Divisekara/Power-Supply-100W/photos/20190405_001616.jpg

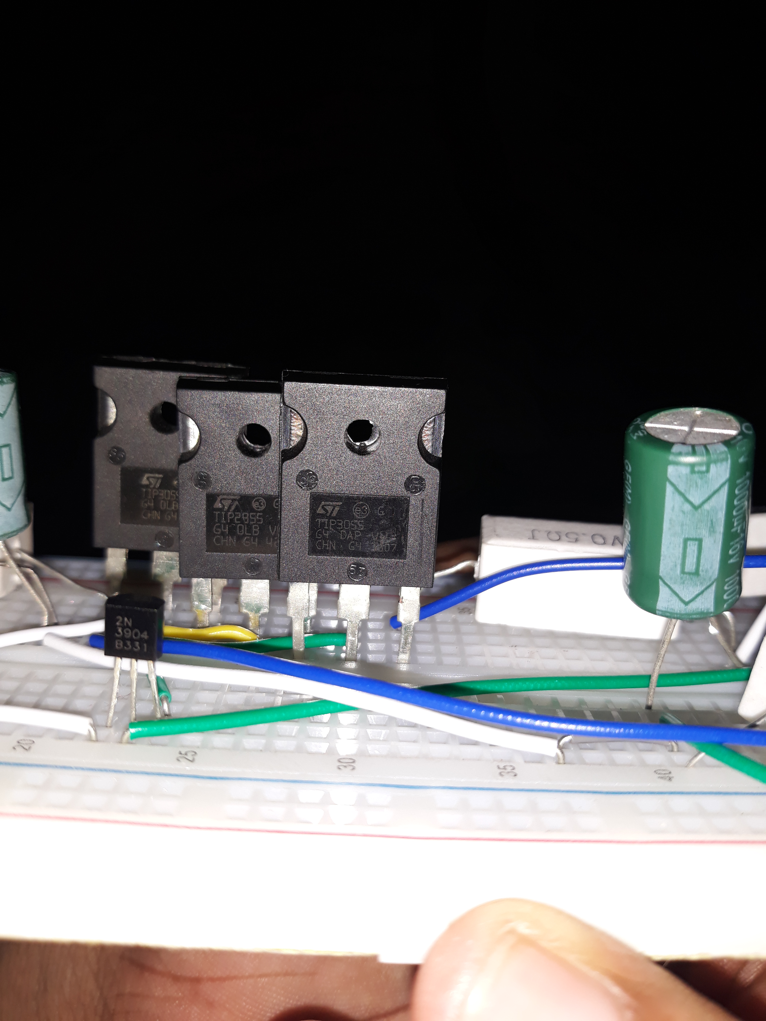
photos/20190405_001616.jpg
