Divisekara/Power-Supply-100W/README.md

# Power Supply 100W
 Smester 3 Lab project
