Divisekara/Power-Supply-100W/POWER SUPPLY/Preliminary Design.docx

Preliminary Design

AC input (230v)

Step Down Transformer

Full Wave Rectifier

Voltage Regulator

Current Amplifier

Output 100W 10A max

SECONDARY DESIGN (With Feedback Circuit )

Current Amplifier

Output 100W 10A max

Unregulated Input

Feedback signal

Reference voltage

Comparator circuit

Sampling circuit
