Divisekara/Power-Supply-100W/POWER SUPPLY/sathira.docx

week1

week2

week3

week4

week5

week6

week7

week8

concept research and circuit simulation

Preliminary Circuit design

Circuit design Finalizing

PCB design and Printing

Soldering and assembly of electronic components

Testing and debuging

Circuit finalizing and Documenting

Enclosure design and Finishing

Report preparation

project time line

April

March
