Divisekara/Power-Supply-100W/POWER SUPPLY/Preliminary Design.pdf

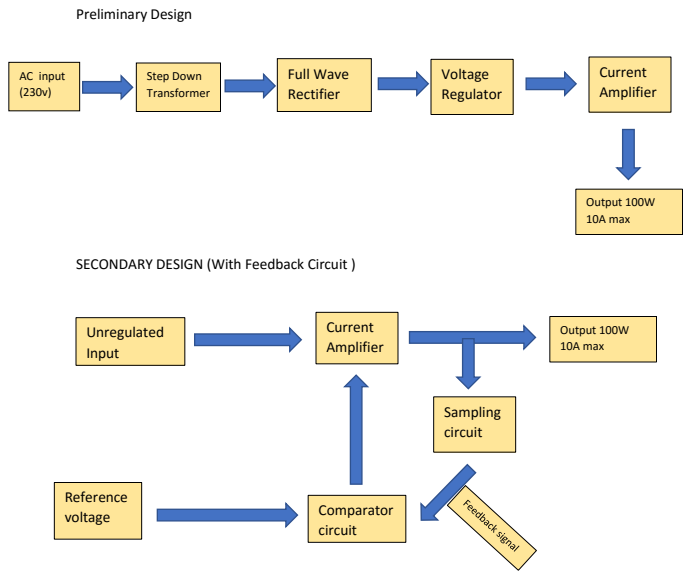
[picture p10: page 1]
Preliminary Design; AC input (230v); Step Down Transformer; Full Wave Rectifier; Voltage Regulator; Current Amplifier; Output 100W 10A max; Unregulated Input; Reference; voltage; Comparator; circuit; Sampling circuit

SECONDARY DESIGN (With Feedback Circuit )
