Divisekara/Power-Supply-100W/PROJECT OUTLINE TO BE PRINTED/BLOCK DIAGRAM.pdf

## Preliminary Design

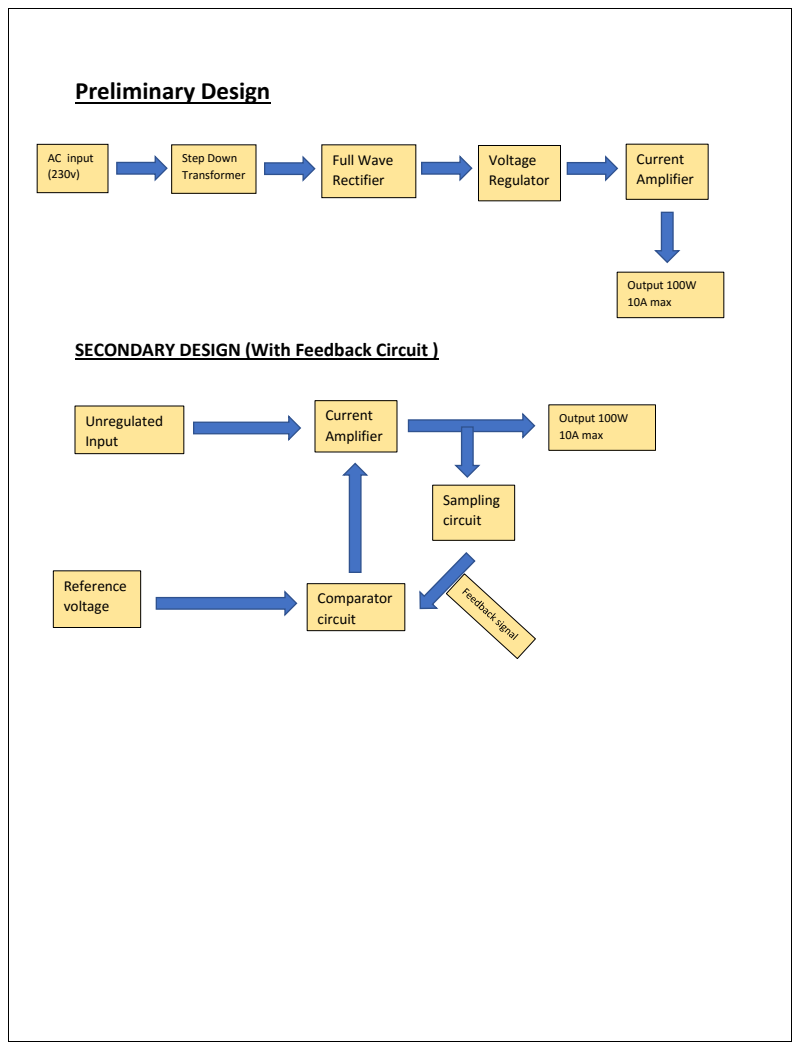
[picture p11: page 1]
AC input (230v); Output 100W 10A max; Step Down Transformer; Full Wave Rectifier; Voltage Regulator; Current Amplifier; Unregulated Input; Reference; voltage; Comparator; circuit; Sampling circuit

SECONDARY DESIGN (With Feedback Circuit )
