Divisekara/Power-Supply-100W/(list of files, drawings)

Other design files:
from sathira/original circuit.ms14
from sathira/PCB1.PcbDoc
from sathira/PCB3.PcbDoc
from sathira/PCB4.PcbDoc
from sathira/PCB4copy.PcbDoc
from sathira/PCB5RECTIFIER.PcbDoc
from sathira/Sheet1.SchDoc
from sathira/Sheet1new.SchDoc
Imported 1935161.lia/1935161.PcbLib
Imported 1935161.lia/1935161.SchLib
multisim files/ace circuit eka.ms14
multisim files/blocks.ms14
multisim files/Design1.ms14
multisim files/Design1_modified.ms14
multisim files/last1.ms14
multisim files/original circuit changes.ms14
multisim files/original circuit.ms14
New folder/PCB4.PcbDoc
New folder/sathira.PcbDoc
PCB4 (1).PcbDoc
PCB4.PcbDoc
PCB_Project/PCB2.PcbDoc
PCB_Project/PCB_Project.PrjPcb
PCB_Project/Sheet2.SchDoc
POWER SUPPLY/blocks.ms14
POWER SUPPLY/Design1_modified.ms14
power_s_1/power_s_rectifier/power_s_rectifier.PrjPcb
power_s_1/power_s_rectifier/Sheet1.SchDoc
